NMM-2009/Arduino-Radar-Project/(commit log)

2026-07-19 Enhance README with detailed project description and sections
    Expanded project description and added parts, wiring, and future enhancements sections.
2026-07-19 Add detailed build notes and project challenges
    Documented the build process and challenges faced while working on the project, including wiring, coding, and troubleshooting.
2026-07-19 Add Known Issues section to README
    Added a section for known issues regarding servo movement and power sources.
2026-07-19 Update known issues section in README
    Clarified known issue regarding servo movement when powered by battery.
2026-07-19 Update Notes with project progress and challenges
    Documented progress on buzzer functionality, servo control issues, and LCD1602 module integration. Explained adjustments made for contrast and pin connections.
2026-07-20 Enhance LCD output and adjust servo delay
    Added functionality to output data to the LCD screen and refreshed it on state changes. Adjusted resistor values for better contrast and reintroduced delay for servo operation.
2026-07-20 Update build notes for Day 1 and Day 2
    Documented progress and issues encountered during the first two days of the project, including wiring, coding, and component adjustments.
2026-07-20 Revise known issues in README.md
    Updated known issues section to reflect resolution of servo sweep speed adjustment issue and added explanation.
2026-07-20 Revise README with improved wiring table and LCD info
    Updated wiring table format and added LCD wiring details.
2026-07-20 Revise project notes and add details on LCD integration
    Updated notes on project progress, including issues with servo control and LCD1602 Module integration.
2026-07-20 Add schematic section to README
    Added schematic image reference to README.
2026-07-20 Replace schematic image with JPG version
    Updated schematic image from PDF to JPG format.
2026-07-20 Enhance servo loop and explore Arduino-Python communication
    Updated servo loop to use millis() for non-blocking operation and researched Arduino-Python serial communication.
2026-07-20 Documented updates on Arduino and Python serial communication
    Resolved serial port busy error in Python-Arduino communication.
2026-07-20 Revise notes on servo and Python serial communication
    Updated notes on servo functionality and Python-Arduino communication.
2026-07-20 Add radar_visual.py for reading Arduino data
2026-07-20 Enhance README with code links and issue resolution
    Updated README to include links to both Arduino and Python code, and resolved a known issue regarding servo sweep speed.
2026-07-21 Enhance notes on Arduino-Python serial communication
    Updated notes on Arduino and Python communication, including troubleshooting and project structure.
2026-07-21 Add angle printing to radar output
2026-07-21 Refactor button check and update data transmission
    Refactor button check and servo control logic to improve timing accuracy. Update data transmission format to include angle, distance, and detection status.
2026-07-21 Refactor serial reading into getData function
    Refactored serial reading into getData function for better modularity and error handling.
    [data_fetcher.py]
2026-07-21 Refactor button check and improve data sending
2026-07-21 Revise project notes and update component details
    Updated notes on project progress, including issues with servo control and LCD module integration. Adjusted resistor values for better contrast and refined function for LCD data output.
2026-07-21 Update README with software requirements
    Added software requirements for Arduino and Python, including library dependencies and installation instructions.
